ne9n/new-timer/MODEL_AVIATION_ARTICLE.md

# Smart Electric Power at EAA KidVenture

**By David Siegler, AMA NE9N**  
*Circle Masters Control Line Club*  
*For submission to Model Aviation Magazine*

---

## 1,500 Flights in Seven Days

Every summer at EAA AirVenture in Oshkosh, Wisconsin, the Circle Masters Control Line Club runs introductory flights for kids at Pioneer Airport. The club has been doing this for over 30 years. Modelers from across the country and around the world come to Oshkosh to help out. In just seven days, our crew gives more than 1,500 flights to kids who have never held a control handle before.

For years, the club flew small Norvel .061 glow engines. They did the job, but running them all day was hard work. Every flight circle needed three people: one to prime and fuel, one to hold the starter battery and electric starter, and one to hold the plane. Finding parts, fuel, and people who knew how to tune small glow engines was getting harder every year. Refueling after every 90-second flight caused constant lines and delays.

We decided to switch to electric power. But off-the-shelf timers did not fit how we fly at Oshkosh. So over three summers of field testing, I developed my own setup: the **Cheesehead Timer**.

---

## One Pit Man, Seven Flights per Battery

Going electric changed everything on our flight line:

* **One-person pits:** The flight line went from three pit crew members down to one. The pit man holds the plane, pushes a button on the fuselage, and hand-launches it.
* **Seven flights per pack:** I use a cheap 3S 2,200 mAh LiPo battery and a budget 2807-size brushless motor. That single battery gives six to seven 90-second flights before needing a battery swap.
* **Fast turnarounds:** When a flight ends, the next kid takes the handle. The pit man hits the button, launches, and the plane is in the air in seconds.
* **A consistent student experience:** With glow engines, one run was rich and sluggish, the next leaned out too fast, or the engine died after 45 seconds. With the timer, every single student gets the exact same flight: an identical launch, the same steady cruise speed, and a full 90 seconds in the air. Instructors know exactly what the plane will do every flight.

---

## Launch Power and Training Speed

Our circles sit right next to active helicopter flight paths at Pioneer Airport. Passing rotor wash and summer wind gusts make for rough air down low.

We hand-launch every airplane. Here is the problem with training:
* If you launch at a slow training speed, the airplane struggles the first two laps to pick up airspeed and get tossed around by wind or rotor wash.
* If you run full throttle the whole time, the plane flies at 50 to 60 mph. That is way too fast for an 8-year-old beginner.
* If the instructor tries to hold a throttle lever while helping the student, their attention is divided.

The timer fixes this with two throttle stages:

1. **Full-power launch:** The motor starts at 100% power for the first couple laps. This gives the hand-launched plane enough thrust to pick up speed quickly, beat the wind, and lock in solid line tension.
2. **Slow cruise:** Once the plane is up and moving, the motor drops to a calm 65% power. The flight slows down so the student can relax and learn to fly level.
3. **The warning "burp":** One lap before flight time ends, the motor revs up for a quick blip. This tells the instructor and student that the motor is about to shut down.
4. **Smooth landing:** The motor ramps down slowly so the plane glides in for an easy touchdown.

---

## How the Software Works

The software is simple and works like a flight checklist. It steps through six basic stages:

1. **Wait:** The timer sits disarmed with a flashing light, waiting for the button press.
2. **Arming delay:** When you press the button, it gives a five-second countdown so the pit man can get set to launch.
3. **Takeoff ramp:** It ramps the motor to full power for the hand launch and holds it there for two laps.
4. **Fly:** It throttles back to cruise speed. While flying, the code reads the gyro sensor 50 times every second to watch for crashes or stunt maneuvers.
5. **Warning blip:** At the end of the flight, it gives a quick throttle "burp" as a landing heads-up.
6. **Ramp down:** It smoothly cuts the throttle so the plane glides in for a touchdown.

All speed settings, timing intervals, and IMU sensor configurations are fully programmable by the user. You can easily adjust launch power, cruise speed, countdown delays, flight duration, and sensor sensitivities (such as crash-detection cutoffs and stunt maneuver boost) to match your specific model and flying style.

The code talks to standard speed controllers using the same regular servo signals any RC receiver uses. It is written in simple C++, so anyone who has used an Arduino can open the file, read it, and change values directly. Behind the scenes, this constant IMU monitoring is what makes our automatic crash protection possible.

---

## Protecting Motors in a Crash

When a glow engine hits the ground, the prop stops and the engine stalls. Electric motors do not do that.

If an electric plane hits the ground and the timer keeps running, the stalled motor pulls massive current. Within three or four seconds, the heat melts the copper wire windings and destroys the speed control (ESC).

To stop this from happening, I added an inexpensive MPU-6050 gyro sensor to the board:

* **Impact shutoff:** If the nose hits the ground, the sensor catches the shock and kills power in milliseconds. Motors and ESCs do not burn up anymore.
* **Stop shutoff:** If the plane stops spinning around the circle, the timer cuts power right away.
* **Slack line safety:** If a line breaks or the plane turns inward toward the circle, the motor shuts off immediately.

---

## Sport and Competition Flying

Although I developed the timer for KidVenture training, it is not just for beginners. By loading alternate settings, the timer works great for weekend sport flying and Precision Aerobatics (Stunt) competition.

The inspiration came from a trip I took in 2017 to an indoor control line contest in the Czech Republic. Pilots were flying full aerobatic stunt patterns inside a gym on short 15-foot lines. Their models flew very slowly on level laps, but the second the nose went up for a loop or a corner, the motor spooled up to give extra pull.

I built that same capability into the timer for sport and competition models:

* **Corner boost:** When you pull up for a loop, square corner, or vertical eight, the gyro senses the pitch rate and adds throttle to keep line tension solid.
* **Pitch trim:** The timer boosts power on vertical climbs and reduces throttle on dives. It acts just like the classic "4-2-4" engine break on a glow stunt engine.
* **Custom flight profiles:** You can dial in higher cruise power, longer flight times, or exact lap counts for official contest flights, turning a tame trainer into a responsive stunt ship in seconds.

---

## Simple Hardware and STEM Projects

The timer runs on a cheap, standard Arduino Nano board and a gyro module. I designed a small circuit board that everything plugs into, so there are no loose or messy wires.

Because the parts are cheap and the code is open-source, this is a great project for school STEM clubs and youth build sessions. Kids can build the board, plug it in, and see how sensors, software, and motors work on a real model airplane.

I also wrote a simple computer app. You can plug the timer into a laptop with a USB cable and change speeds, launch power, and flight times in seconds.

---

## What Comes Next & How You Can Help

I am working on several new features:
* **Direct ESC telemetry:** Direct digital connection to the speed controller to monitor motor temperature, battery current, and RPM live in flight.
* **Smaller dedicated hardware:** A tiny all-in-one circuit board with built-in wireless connections so you can adjust settings from a phone right at the flight line without plugging in cables.
* **Twin-engine controls:** Multi-motor support with synchronized spool-up and differential thrust to keep lines tight on scale twins.
* **Retract gear sequencing:** Dedicated servo control to tuck the gear away after climbout and drop it before landing.
* **Voltage compensation:** Automatic throttle adjustments to keep lap times identical as the battery voltage drops over multiple flights.

### Join Us at KidVenture or on GitHub
I would love extra help from the aeromodeling community on two fronts:

1. **Help on the flight line:** If you are attending EAA AirVenture in Oshkosh, come join our volunteer crew at Pioneer Airport. We can always use extra flight coaches, pit crew, and line tenders. It is one of the most rewarding weeks of flying you will ever experience.
2. **Help with new features:** If you enjoy coding, building electronics, or testing new ideas, jump into the open-source project on GitHub. Whether you want to help write phone apps, test twin-engine profiles, or build circuit boards, you are welcome to pitch in.

Send me an email or check out the project links below to get involved.

---

## Photo Captions

* **Photo 1 (`fig1_kidventure_line.jpg`):**  
  *Caption:* An instructor coaches a young first-time flyer at EAA KidVenture in Oshkosh. (13 words)

* **Photo 2 (`fig2_launch_sequence.jpg`):**  
  *Caption:* Full power at launch helps the hand-launched trainer pick up speed before dropping to cruise. (16 words)

* **Photo 3 (`fig3_carrier_board.jpg`):**  
  *Caption:* The circuit board plugs directly into the Arduino, gyro sensor, and speed control. (13 words)

* **Photo 4 (`fig4_battery_turnaround.jpg`):**  
  *Caption:* One 3S 2,200 mAh LiPo battery powers six to seven flights with quick pit turnarounds. (15 words)

* **Photo 5 (`fig5_motor_protection.jpg`):**  
  *Caption:* Built-in gyro sensors shut off the motor instantly during crashes to protect the electronics. (14 words)

* **Photo 6 (`fig6_stunt_operation.jpg`):**  
  *Caption:* For sport and stunt flying, the gyro adds power in corners and climbs. (14 words)

* **Photo 7 (`fig7_stem_workbench.jpg`):**  
  *Caption:* The low-cost Arduino setup makes this an easy project for school STEM clubs. (13 words)

---

## Resources

* **Club Website:** Circle Masters Control Line Club ([http://www.circlemasters.com](http://www.circlemasters.com))
* **Author Contact:** David Siegler, AMA NE9N (`dwsiegler@gmail.com`)
* **Project Files & Code:** [https://github.com/ne9n/new-timer](https://github.com/ne9n/new-timer)
* **Setup:** 2807 brushless motor, 30A ESC, 3S 2,200 mAh LiPo battery, 8x4 prop
* **Electronics:** Arduino Nano, MPU-6050 gyro board, custom plug-in PCB
