ne9n/new-timer/(threads)

Thread 2 (2021-11-06):

input switch not debounced

ne9n, 2021-11-06:
need to debounce SW1

ne9n, 2021-12-18:
used D13 for input d13 has series resitor need 10k pulldown and button cnnected to +5 hacked pcb

Closed 2021-12-18.

Thread 4 (2021-11-06):

Add gyro calibration routing

ne9n, 2021-11-06:
Should run once from the menu and save cal value to EPROM

ne9n, 2021-11-08:
Also, any offsets and/ or pitch yaw swaps would be added
goes to pitch or yaw
uses abs or not

ne9n, 2021-12-18:
giro now does a offset calc every time.
x and y axis can be swapped px, py and rx, ry added
use abs() on roll axis

Closed 2021-12-18.

Thread 5 (2021-11-06):

Improve meun controls

ne9n, 2021-11-06:

ne9n, 2021-12-18:
Cleaned up menu  vt 100 commands do not work over arduino ide

Closed 2021-12-18.

Thread 9 (2024-11-03):

motor cuts out when moving from accel to cruse

ne9n, 2024-11-03:
anti crash function fails on fist time its run must be an unitilized variable.
