ne9n/new-timer/cheesehead_timer/state_machine.cpp

/*
 *  
 *  speedState  manages idle, ramp up and landing phases.   
 *  could be combined into a single state machine.   
 *  state variable is speed_state
 */

/*

*/
#include <Arduino.h>
#if defined(ESP32)
#include <ESP32Servo.h>
#else
#include <Servo.h>
#endif
#include "state_machine.h"
#include "cheesehead_timer.h"

extern param TimerSetup;
extern Servo esc;
extern bool run_state;
extern speed_state ispeed_state;
extern int iangleZ;
extern void set_led(int);
unsigned long currentMillis;
unsigned long previousMillis;
int lastZ = 0;
long angle_time = 0;
int curThrottle;
int motorThrottle = 0; // global current active motor speed (0-180)
bool gyro_flag = false;

// Track when we entered the FLY state for auto-increase
static unsigned long flyStartMillis = 0;

extern bool PitchEX;
extern bool YawEX;
extern bool YawLOW;


 /*defaultvalues for states up above */
 unsigned long state_timer[] = {

  1000, /* 0 wait*/
  3000, /* 1 armed*/
  5000, /*2  spin up */
  5000, /* 3 full speed */
  600000, /*4 fly*/
  500, /*5 Burp*/
  2000, /*6 ready land */
  3000  /* 7 land*/
 };




bool check_state()
{
  currentMillis = millis();
 /* delay(1000);
  Serial.print(ispeed_state); 
  Serial.print("  ");
  Serial.print((currentMillis - previousMillis));
  Serial.print("  ");
  Serial.print (state_timer[ispeed_state]);
  Serial.print(" check state info \n"); 
*/
  if  ((currentMillis - previousMillis)  > (state_timer[ispeed_state]))
  {
  
  
    
    // inc the state and make it wrap 8 states 

   // advance state
   ispeed_state = static_cast <speed_state>((static_cast<int>((ispeed_state)+1)%8));
    previousMillis = currentMillis;
    
    return true;
  
   }
   else
    return false;
}

// Set the current speed state and reset the internal previousMillis
void setSpeedState(speed_state newState)
{
  ispeed_state = newState;
  previousMillis = millis();
  if (newState == speed_state::FLY) flyStartMillis = millis();
}

void speedState()
{


 /* Serial.print(ispeed_state); 
  Serial.print(" =state ");
  Serial.print(( curThrottle));
  Serial.print(" =thottle  ");
  Serial.print(( run_state));
  Serial.print(" =run state   ");
  
  Serial.print(" SpeedState \n"); 

  delay(1000);*/

  set_led(ispeed_state);
  switch (ispeed_state)
  {
    case speed_state:: WAIT:
    {
      // once second burst
      curThrottle = 25; /* a quick burp */
      PitchEX = false;
      YawEX =false;
      YawLOW = false;

      // Serial.print("wait   ");
    }
    break;
    case speed_state::ARMED:
    {
      curThrottle = 0;

    }
    break;
    case speed_state::TAKEOFF_RAMP:
    {
      static unsigned long lastRampMillis = 0;
      unsigned long rampDuration = TimerSetup.accelTime[sindex];
      unsigned long elapsed = currentMillis - previousMillis;
      
      if (elapsed >= rampDuration) {
        curThrottle = TimerSetup.FlySpeed[sindex];
      } else {
        curThrottle = (int)(((float)elapsed / (float)rampDuration) * (float)TimerSetup.FlySpeed[sindex]);
      }
      
      angle_time = currentMillis; //pre load this for crashcheck
      lastZ = iangleZ - 10;
    }
    break;
    case speed_state::TAKEOFF:
    {
      curThrottle = TimerSetup.FlySpeed[sindex];
      // init values for crash_check
      if (PitchEX or YawEX)
      {
        curThrottle = 0;
        run_state =false;
      }
    }
    break;
    case speed_state::FLY:
    {
      // base throttle from current profile
      curThrottle = TimerSetup.FlySpeed[sindex];
      // apply automatic increase: percent per minute (TimerSetup.autoSpeedPerMin)
      if (TimerSetup.autoSpeedPerMin > 0 && flyStartMillis > 0)
      {
        unsigned long now = millis();
        unsigned long elapsed = (now - flyStartMillis);
        // compute fractional minutes
        float minutes = (float)elapsed / 60000.0f;
        float extraPercent = ((float)TimerSetup.autoSpeedPerMin) * minutes; // percent
        long extra = (long)((curThrottle * extraPercent) / 100.0f + 0.5f);
        curThrottle += (int)extra;
      }
      if (PitchEX or YawEX or YawLOW)
      {
        curThrottle = 0;
        run_state = false;
      }
    }
    break;
    case speed_state::BURP:
    {
      curThrottle = BurpMax;
    }
    break;
    case speed_state::RDYLAND:
    {
      curThrottle = TimerSetup.FlySpeed[sindex];
      
    }
    break;
    case speed_state::RAMPDWN:
    {
      curThrottle = 0;
      run_state = false; 
  
    }
    break;
    default:
    {
      curThrottle = 0;
      run_state = false;
 
    }
    break;
  }
  // apply pitch trim (`posTrim`) and maneuver boost (`maneuverBoost`) and clamp throttle
  extern int posTrim;
  extern int maneuverBoost;
  long adjusted = (long)curThrottle + (long)posTrim + (long)maneuverBoost;
  if (adjusted < 0) adjusted = 0;
  if (adjusted > MAX_SPEED) adjusted = MAX_SPEED;
  
  if (!run_state) adjusted = 0; // Absolute safety cutoff
  
  motorThrottle = (int)adjusted;
  esc.write(motorThrottle);
}
