ne9n/new-timer/(commit log)

2026-01-16 Fix compile warnings: set_led signature, maxThrottle init, enum handling, mark unused param; compile clean
    [ButMenu.cpp, cheesehead_timer.h, cheeshead_timer.ino, gyro.cpp, led.cpp, state_machine.cpp]
2026-01-19 Run MPU calibration only on first run; add factory-reset (V) menu; expose setUpMPU prototype
    [cheeshead_timer.ino, gyro.cpp, gyro.h, term.cpp, term.h]
2026-01-19 Print menu/telemetry instructions after init
2026-01-19 Remove noisy LED state serial prints
2026-01-20 osh26exp: add PlatformIO tests, auto-calibration, auto-speed-per-minute, utilities and docs
2026-01-20 platform: add esp32 environment
2026-01-20 esp32: EEPROM init/commit for ESP32
2026-01-21 Add gyro unit tests and Arduino host stubs
2026-01-21 Add gyro lap-accumulation rollover unit tests
2026-01-21 Remove PlatformIO config and native board manifest (use g++/Makefile tests)
2026-03-04 Add configuration upload and download terminal commands - Added 'w' to upload a comma separated configuration string - Added 'p' to print the configuration string backward compatible with 'w' - Repla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
    [cheeshead_timer.ino, gyro.cpp, state_machine.cpp, term.cpp]
2026-05-16 added swapping axies and improvm, et in desktop
    [cheesehead_timer.h, cheeshead_timer.ino, desktop_app.py, gyro.cpp, term.cpp]
2026-05-16 feat: add desktop application and implement configurable axis mapping for gyro sensor readings
2026-05-16 Add feature to configure MPU axis mapping to Pitch, Roll, Yaw
2026-05-16 add readme.md
    Added detailed operation documentation for the Cheesehead Timer project, covering purpose, hardware pins, configuration, lap counting, state machine, crash detection, and serial terminal commands.
2026-05-16 updated arduino_flowchart
2026-06-28 Refactor: Activate safety logic, optimize memory with F() macros, and fix compilation errors
    [ButMenu.cpp, cheesehead_timer.h, cheesehead_timer.ino, desktop_app.py, gyro.cpp, gyro.h, led.cpp]
2026-06-29 Add README for Cheesehead Timer OSH26
    Added detailed documentation for Cheesehead Timer OSH26, including features, hardware architecture, quick start guide, axis mapping, configuration commands, and attribution.
2026-07-29 docs: Add bench integration test guide and expand manual with LED patterns and error conditions
2026-07-29 feat: Implement dynamic motor speed flash rate on Green LED3
2026-07-29 docs: Add User Button Controls section to manual.md
2026-09-21 Add Model Aviation feature article manuscript for EAA KidVenture timer
2026-09-21 Add twin-engine support and landing gear sequencing to future enhancements
2026-09-21 Highlight approachable Arduino hardware/software architecture and STEM education applications
2026-09-21 Add Czech contest backstory details on 15-foot lines, motor spool-up, and full FAI aerobatic patterns
2026-09-24 Note that all speeds, IMU settings, and time intervals are fully programmable by the user
2026-09-24 Add direct ESC telemetry and compact wireless hardware to What Comes Next section
2026-09-24 Add transition sentence linking software IMU operation to crash protection
2026-10-20 Add Arduino build workflow for Nano binaries
    This workflow automates the building of Arduino Nano binaries for both new and old bootloader versions, compiling sketches and saving the output as artifacts. need folder paths and all libs used
